NoahCallaway/midi-stomptroller/README.md

# midi-stomptroller
4-Switch MIDI controller for the Line6 Helix Stomp

[**Docs and build info here**](https://noahcallaway.github.io/midi-stomptroller/)

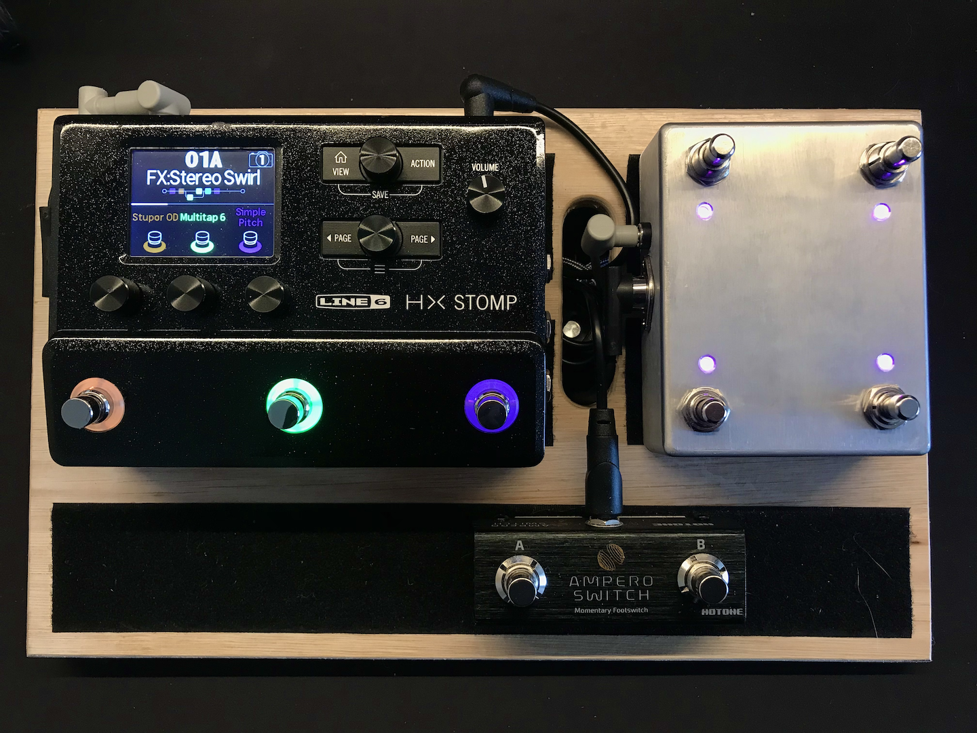
[picture p1: docs/static/img/helix_pedal.png]
Helix and Pedal


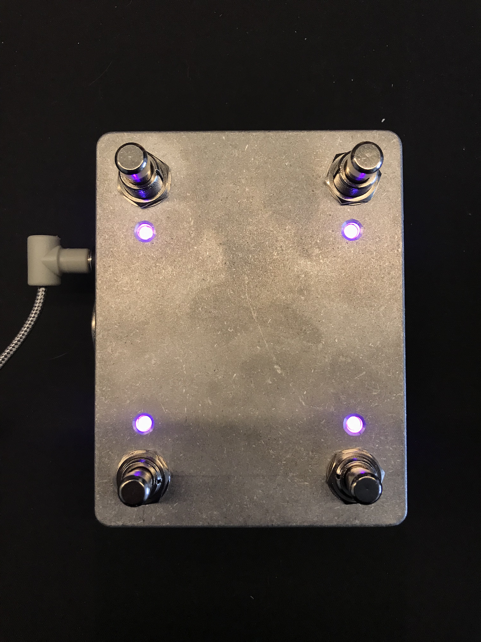
[picture p2: docs/static/img/pedal_on.png]
Pedal
