NoahCallaway/midi-stomptroller/docs/docs/arduino-flashing/requirements.md

---
sidebar_position: 1
---

# Requirements

- Install the [Arduino IDE](https://www.arduino.cc/en/software)
- Required libraries:
    - https://github.com/M-tech-Creations/NoDelay
    - https://github.com/FortySevenEffects/arduino_midi_library/
    - https://github.com/adafruit/Adafruit_NeoPixel
    - https://github.com/mathertel/OneButton

## Installing Libraries

Follow the Installation/Getting started instruction for the [NeoPixel](https://github.com/adafruit/Adafruit_NeoPixel) and [MIDI](https://github.com/FortySevenEffects/arduino_midi_library/) libraries.

For the other libraries download and unzip the files then place them in the `Arduino > libraries` folder

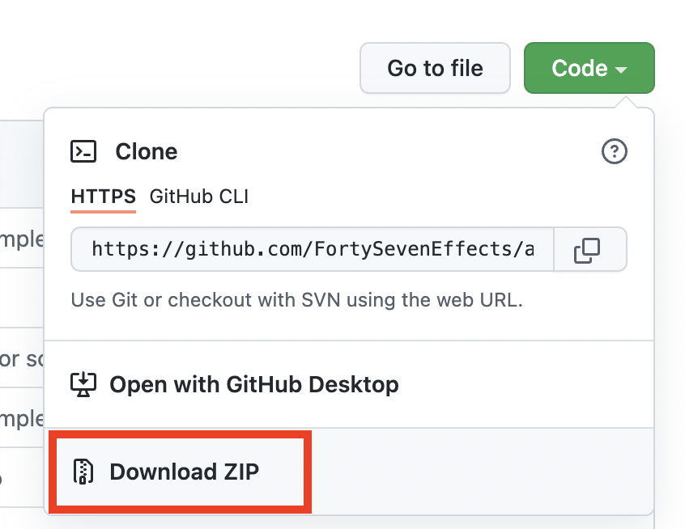
[picture p3: docs/static/img/arduino-flashing/zip_download.png]
Download-Library


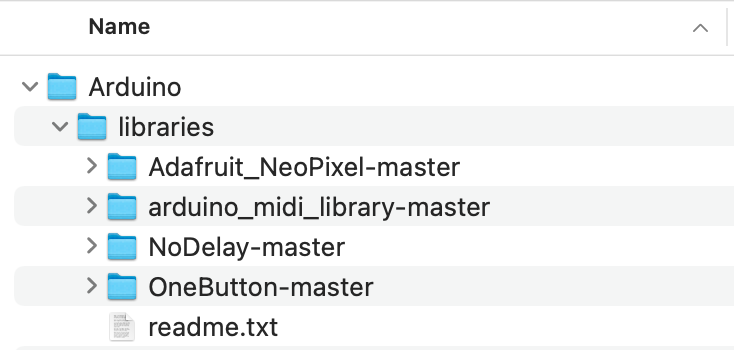
[picture p4: docs/static/img/arduino-flashing/libraries_folder.png]
