NoahCallaway/midi-stomptroller/docs/docs/hardware-build/parts.md

---
sidebar_position: 1
---

# Parts

## UK Parts List 🇬🇧

- [Adafruit ItsyBitsy 32u4 - 5V 16MHz](https://thepihut.com/products/adafruit-itsybitsy-32u4-5v-16mhz-ada3677)
- [5 Pin MIDI Socket](https://www.ebay.co.uk/itm/331900924095)
- [DC Socket](https://www.ebay.co.uk/itm/402811579899?var=673058363591)
- [NeoPixel LED](https://www.ebay.co.uk/itm/324213339212?var=513274703542)
- [Aluminum Housing 120x95x35mm](https://www.ebay.co.uk/itm/313779700479?var=612545663397)
- [SPST Foot Switches](https://www.ebay.co.uk/itm/252235671947)
- [220Ω Resistors](https://thepihut.com/products/resistor-packs?variant=37986550612163)
