NoahCallaway/midi-stomptroller/(list of files, drawings)

Other design files:
docs/docs/fritzing_diagram.fzz
