NoahCallaway/midi-stomptroller/docs/docs/hardware-build/circuit_diagram.md

---
sidebar_position: 4
---

# Circuit Diagram

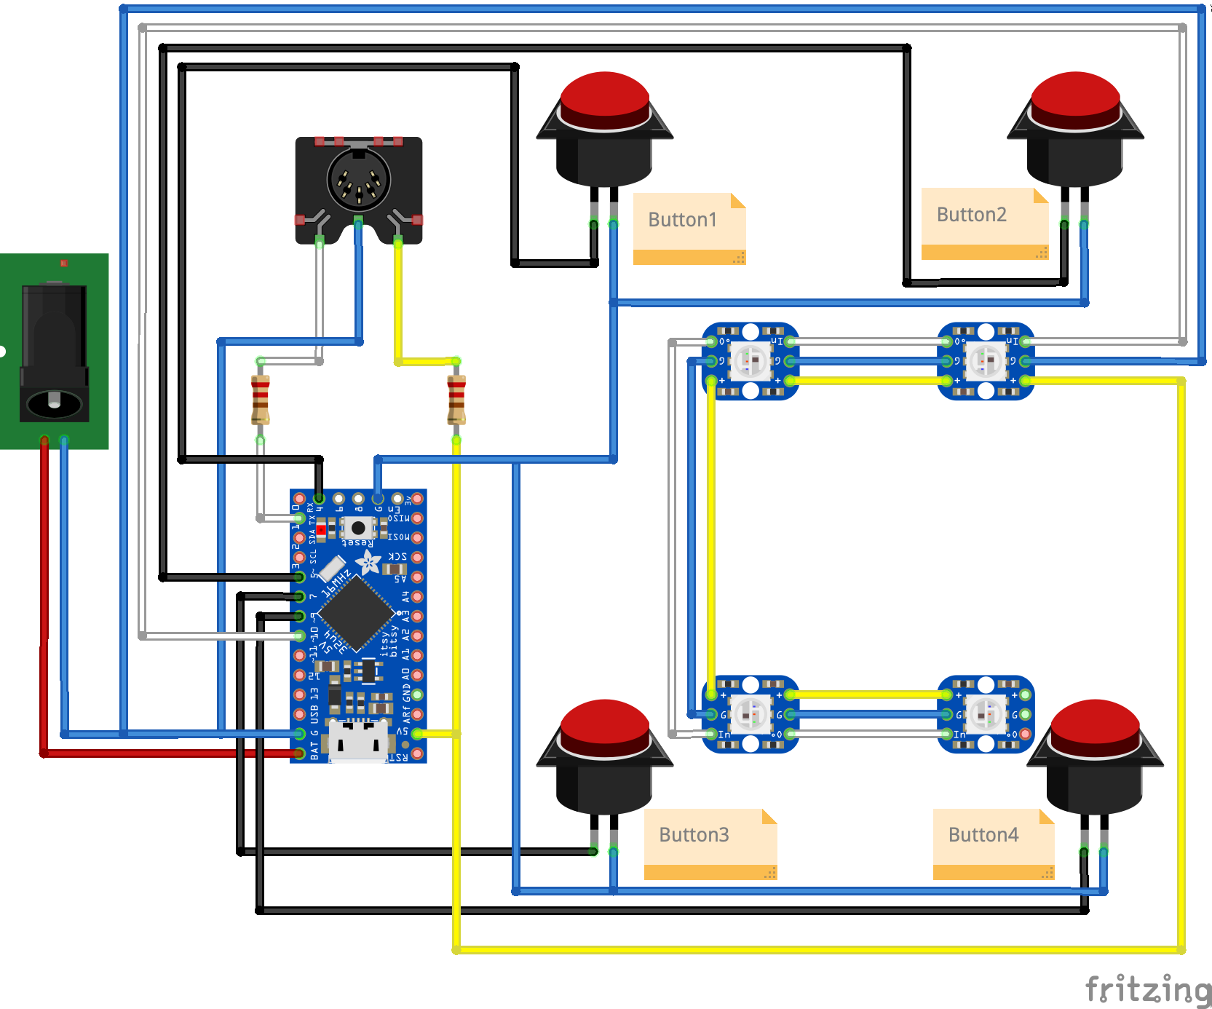
[picture p6: docs/static/img/build/fritzing_diagram.png]
Circuit Diagram


| Colour | Use |
|---|---|
| Red | 5V-12V DC |
| Yellow | 5V DC |
| Blue | GND |
| Black  | GPI |
| White  | Data |
