NoahCallaway/midi-stomptroller/docs/docs/hardware-build/complete_assembly.md

---
sidebar_position: 5
---

# Complete Assembly

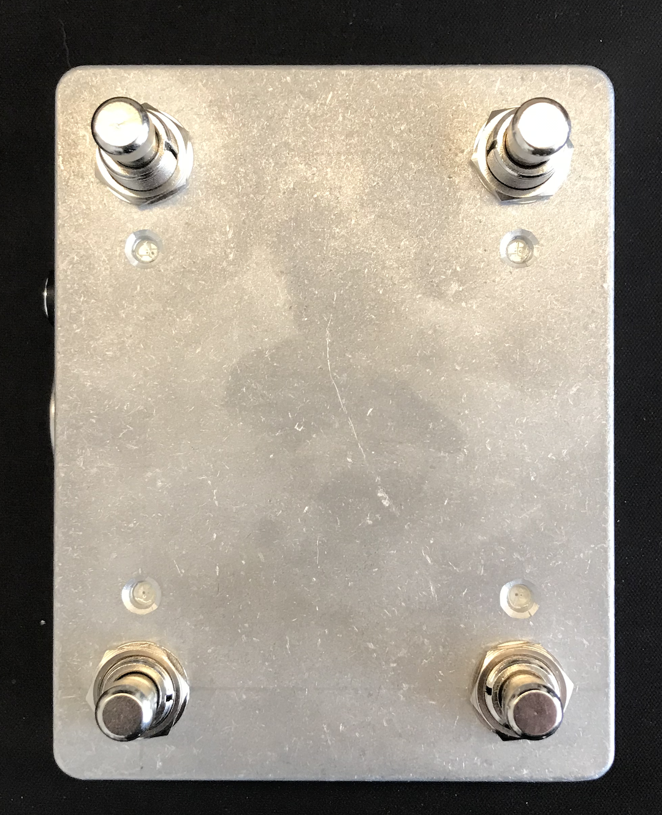
[picture p7: docs/static/img/build/external_1.png]
External


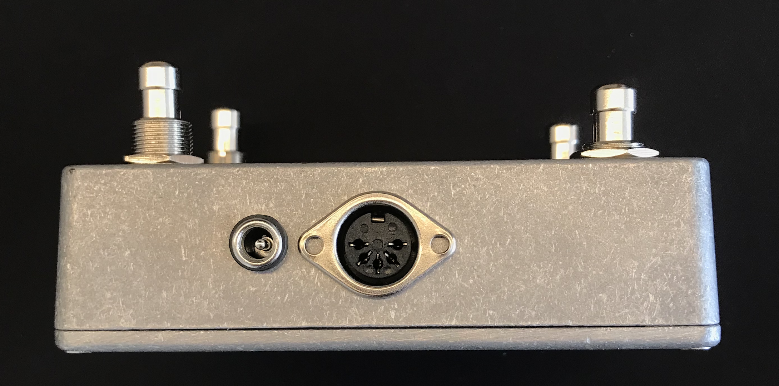
[picture p8: docs/static/img/build/external_2.png]
External


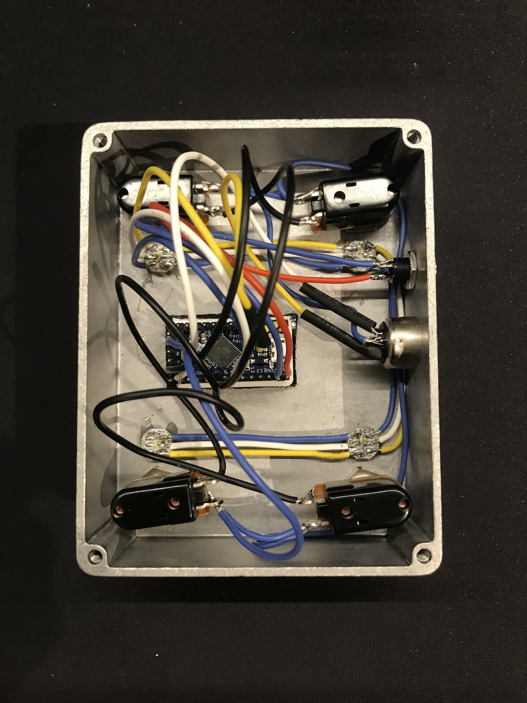
[picture p9: docs/static/img/build/internal_1.png]
Internal


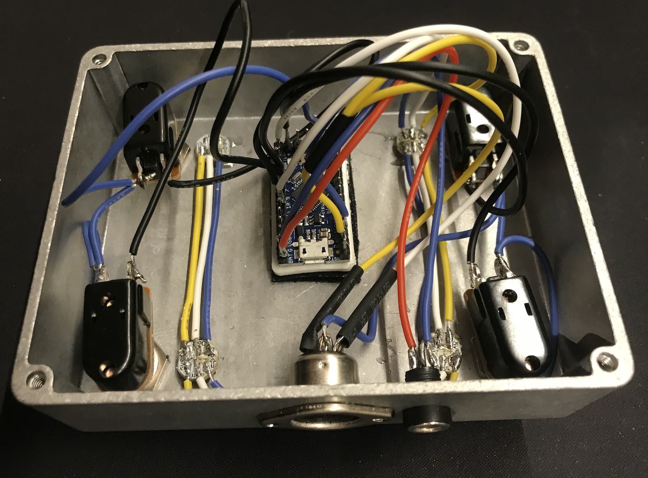
[picture p10: docs/static/img/build/internal_2.png]
Internal
