NoahCallaway/midi-stomptroller/docs/docs/hardware-build/housing.md

---
sidebar_position: 2
---

# Housing

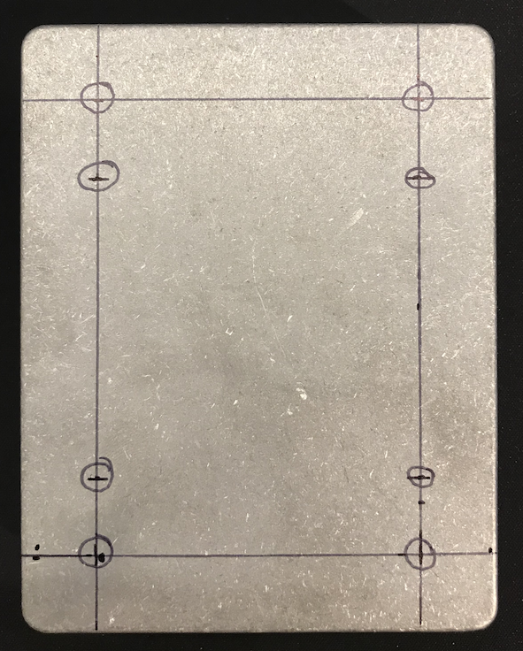
[picture p11: docs/static/img/build/housing_markings.png]
Markings


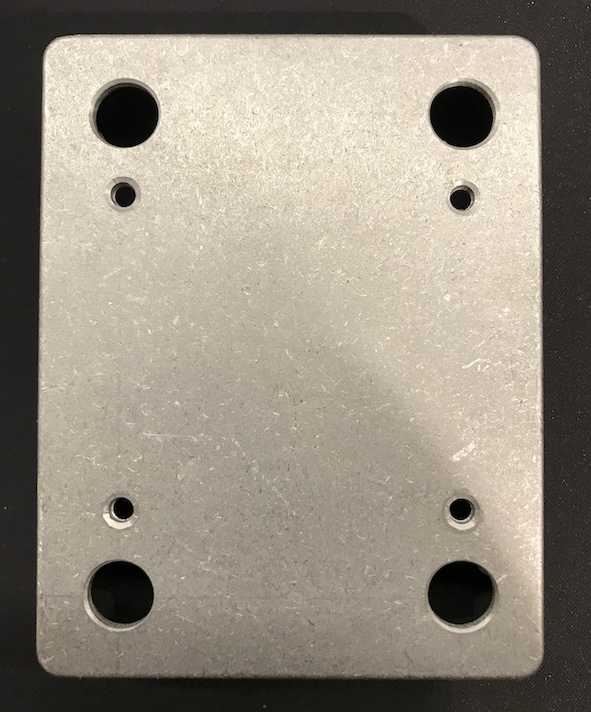
[picture p12: docs/static/img/build/front_holes.png]
Front Holes


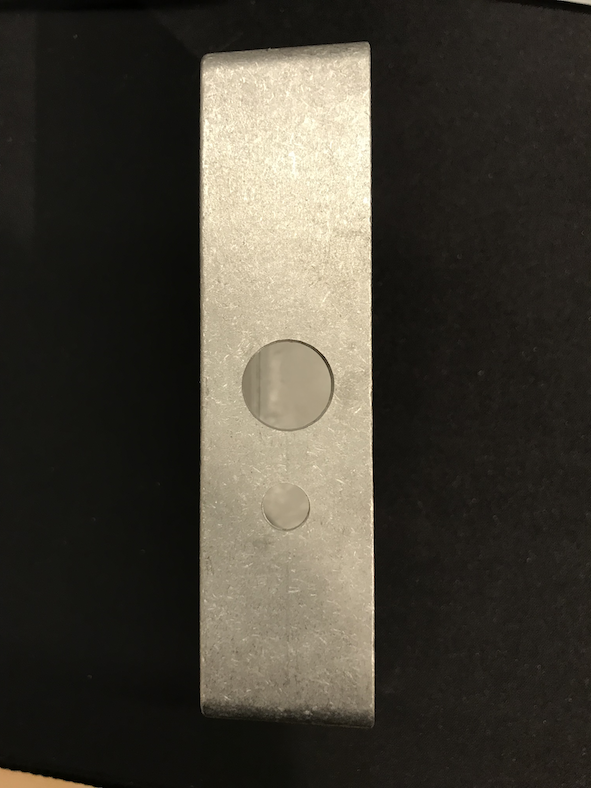
[picture p13: docs/static/img/build/side_holes.png]
Side Holes
