NoahCallaway/midi-stomptroller/docs/docs/hardware-build/mounting.md

---
sidebar_position: 3
---

# Mounting Components

> For the NeoPixel LED's use 2-part epoxy and ensure good coverage to insulate the LED's from the housing.
> Side components left out for now to allow more room when soldering.

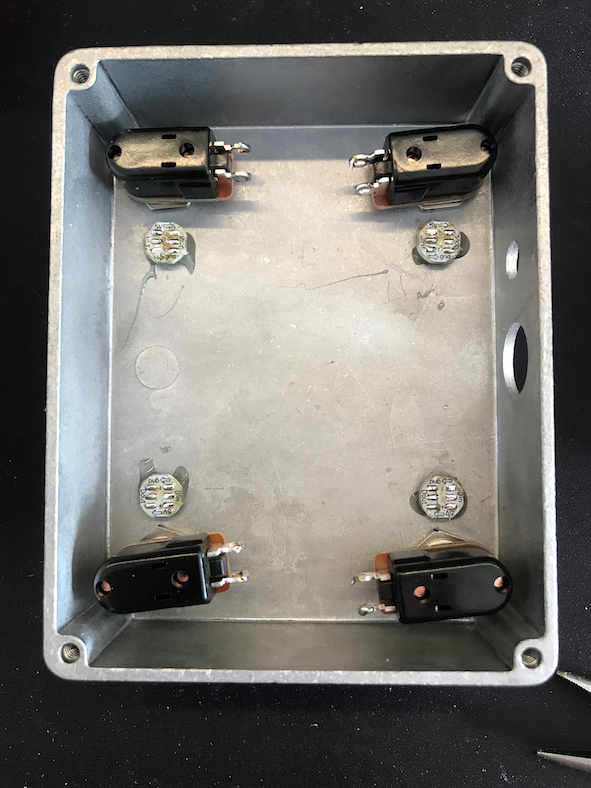
[picture p14: docs/static/img/build/mounted_components.png]
Component Mounting
