NoahCallaway/midi-stomptroller/(commit log)

2022-03-01 Add docs
    [fritzing_diagram.fzz]
2022-03-03 chore: rename docs folder
    [fritzing_diagram.fzz]
2024-04-28 fix error in diagram
    [fritzing_diagram.fzz]
